hjosugi/electronics/docs/01-passive-rj45-design.md

# 1 MCU + パッシブ右手 + 8P8Cの設計

## 8P8CとRJ45という呼び方

一般に「RJ45」と呼ばれる8接点のモジュラーコネクタを使います。厳密には、コネクタ形状は8P8Cであり、RJ45は配線を含む登録ジャック規格名です。本資料では検索性のため「8P8C、通称RJ45」と表記します。

Ethernet用のマグネティクス内蔵ジャックではなく、8接点がそのまま基板へ出るモジュラージャックを選びます。採用部品の機械図、接点番号、シールド端子、内蔵LEDや内蔵抵抗の有無をデータシートで確認してください。

## Japanese duplex matrix

Japanese duplex matrixは、同じ行・列の組に、ダイオード方向が反対の2キーを割り当てる方式です。理論上、`行数 × 列数 × 2` 個のキーを `行数 + 列数` 本の信号で扱えます。

| 片側キー数 | 行 × 列 | 理論上の最大キー数 | 必要な信号線 |
| ---: | ---: | ---: | ---: |
| 18 | 3 × 3 | 18 | 6 |
| 21 | 4 × 3 | 24 | 7 |

42キーでは片側21キーなので、4 × 3の24枠のうち3枠を未使用にします。これはキーレイアウト上の割り当てであり、余った枠を物理キーへ接続する必要はありません。

ダイオード方向を使い分けるため、通常の一方向マトリクスとは走査方法が異なります。QMKで採用する場合は、Cheapinoなどの実装を参考にしつつ、対象キーボード専用のcustom matrix処理とテストが必要です。単に`MATRIX_ROWS`と`MATRIX_COLS`を設定するだけで完成するとは限りません。

## 提案ピン割り当て

次は、この教材で使用する論理ピン割り当てです。実部品の端子番号は、必ずジャックのデータシートと導通試験で照合します。

### 36キー、片側18キー

| 8P8C接点 | 信号 | 用途 |
| ---: | --- | --- |
| 1 | GND | ESD保護の基準、信号走査には本質的に不要 |
| 2 | NC | 将来予約。両側で未接続 |
| 3 | R_COL_0 | 右側Japanese duplex列0 |
| 4 | R_COL_1 | 右側Japanese duplex列1 |
| 5 | R_COL_2 | 右側Japanese duplex列2 |
| 6 | R_ROW_0 | 右側Japanese duplex行0 |
| 7 | R_ROW_1 | 右側Japanese duplex行1 |
| 8 | R_ROW_2 | 右側Japanese duplex行2 |

### 42キー、片側21キー

| 8P8C接点 | 信号 | 用途 |
| ---: | --- | --- |
| 1 | GND | ESD保護の基準 |
| 2 | R_ROW_3 | 右側Japanese duplex行3 |
| 3 | R_COL_0 | 右側Japanese duplex列0 |
| 4 | R_COL_1 | 右側Japanese duplex列1 |
| 5 | R_COL_2 | 右側Japanese duplex列2 |
| 6 | R_ROW_0 | 右側Japanese duplex行0 |
| 7 | R_ROW_1 | 右側Japanese duplex行1 |
| 8 | R_ROW_2 | 右側Japanese duplex行2 |

36キーと42キーで同じPCBを共用したい場合、接点2だけを未実装または`R_ROW_3`として扱えます。信号名、コネクタ番号、ケーブル側の接点番号をシルクと回路図の両方へ記載してください。

## GND線の意味

右側がスイッチとダイオードだけなら、キー電流は行線から列線へ戻るため、GNDはキーマトリクス走査そのものには必要ありません。それでも1本をGNDへ割り当てる理由は次の通りです。

- コネクタ付近のTVSアレイに短い帰路を与える
- ケーブルや筐体の静電気をMCUの信号ピン以外へ逃がす設計余地を残す
- 将来のシールド接続を検討しやすくする

GNDを設けただけでESD対策が完了するわけではありません。TVSの配置とGNDへの経路インダクタンスが重要です。右側へTVSを置く場合も電源は不要ですが、漏れ電流、接合容量、スタンドオフ電圧を確認します。

## 直列抵抗

MCUのGPIOと8P8Cコネクタの間に、各信号1本ずつ直列抵抗を入れます。

```text
RP2040 GPIO ── 470 Ω ── 8P8C ── ケーブル ── 右側スイッチ行列
```

初号機の採用値は470 Ωです。3.3 Vが理想的にGNDへ短絡した単純計算では、抵抗だけで制限される電流は次の値です。

| 直列抵抗 | `3.3 V / R` | 備考 |
| ---: | ---: | --- |
| 220 Ω | 15.0 mA | MCUによっては大きい。無条件には推奨しない |
| 330 Ω | 10.0 mA | 比較候補 |
| 470 Ω | 7.0 mA | 採用。信号立上りと入力閾値はngspiceと実機で確認する |

実際にはGPIO出力抵抗、ケーブル抵抗、接点抵抗も直列に入ります。一方、MCUの許容値は「設定できるドライブ強度」「通常動作条件」「絶対最大定格」「全GPIO合計」で意味が異なります。上表だけで安全判定せず、採用MCUと実装ボードのデータシートに照らします。

Japanese duplexで2本のGPIOが逆レベルを駆動して競合した場合、電流経路には原則として両側の直列抵抗が入ります。470 Ωを2本通る理想計算なら約3.5 mA以下になります。ただし、基板上の短絡が抵抗よりMCU側で起きた場合は保護されないため、抵抗はコネクタの近くではなく、信号源であるMCUと外部配線の間に確実に置きます。

## TVSアレイ

TVSはオプションですが、手で頻繁に触る外部コネクタでは配置用フットプリントを確保する価値があります。

- 3.3 V信号に適したスタンドオフ電圧
- キーマトリクスの立上りを壊さない接合容量
- MCUの入力クランプより先にサージ電流を逃がせるクランプ特性
- コネクタ直後に置き、TVSからGNDへの配線を短く太くする

たとえば[TI TPD2EUSB30A](https://www.ti.com/product/TPD2EUSB30A)は2チャネル、3.6 Vの`VRWM`、代表0.7 pFの製品ですが、これは選定例でありBOM確定ではありません。必要チャネル数、パッケージ、実装能力、クランプ電圧を含めて比較してください。

## ケーブルと誤接続対策

- 市販の8P8Cストレート結線パッチケーブルを使う
- クロスケーブル、電話線、片側だけ配列が違う自作ケーブルを混ぜない
- 初回接続前に1-1、2-2、…、8-8の導通をテスターで確認する
- 基板とケースに`SPLIT ONLY / NO LAN / NO PoE`と明記する
- Ethernetスイッチ、ルーター、PoEインジェクターへ接続しない
- LANケーブルと見分けられる短い色やラベルを専用品として固定する

8P8Cを採用する最大の注意点は、Ethernetに見えることです。パッシブ右側へ電源を送らない設計でも、PoE機器や故障した配線への誤接続を安全にする保証はありません。利用者が迷わない外観と表示は回路の一部として扱います。

## 回路図レビューで確認すること

- `VBUS`、`5V`、`3V3`、`RAW`のネットが中央コネクタに接続されていない
- すべての外部マトリクス線が直列抵抗を通る
- コネクタのシールド端子と信号GNDの扱いが意図どおり
- TVSの向き、GND帰路、スタンドオフ電圧が正しい
- 左右コネクタのミラー配置でピン番号が逆転していない
- NC接点に銅箔やテストパッドから意図しない接続がない
- ERCで電源警告を無理に非表示にしていない
