hjosugi/electronics/issues/11-hotplug-test.md

# [test] ホットプラグ安全性テスト計画
Labels: safety,test

## テスト項目 (プロトタイプ完成後)
- 電流制限付き電源で活線挿抜100回 → 全キー動作確認
- 通常の半挿し状態で供給電流、3V3、代表GPIOを観測する。コネクタを傷める斜め挿しや無保護の意図的短絡は行わない
- 誤配線は実LAN機器へ接続せず、無通電の導通試験と電流制限付きfault-injection治具で評価する
- 挿抜中のキー誤入力、押下残り、USB再列挙の有無を記録

## 完了条件
- 試験治具、電流上限、ケーブル、基板SHA、firmware SHAと結果を`docs/`に記録
- 問題があれば個別 issue 化
