hjosugi/electronics/issues/09-sim-protection.md

# [sim] 保護回路の ngspice シミュレーション
Labels: simulation

## 背景
キーマトリクスのデジタル動作はシミュレーションの対象にしない (ERC/DRC と実機で見る)。シミュレーションする価値があるのは中央ケーブルまわりのアナログ部分。

## モデル
- GPIO出力: 電圧源3.3 V + 仮の出力抵抗。最終値はRP2040/採用モジュールのデータシートまたは実測で確認
- 直列抵抗: 220 / 330 / 470Ω を振る
- ケーブル寄生: 実ケーブルの仕様またはLCR測定からR/L/Cを決め、集中定数モデルの妥当性を記録
- TVS: メーカ配布 SPICE モデル (PSpice 形式) を ngspice 向けに変換。難しければ「接合容量 + クランプダイオード」で近似
- 受け側: 採用MCUの入力容量と内蔵プルアップ条件をデータシートから設定

## 見るもの
1. 過渡解析: スキャンパルスの立ち上がり波形。直列 R によるなまりがスキャン周期に対して十分速いか
2. 直列 R とプルアップの分圧で L レベルが閾値を割れているか
3. TVS 容量追加で波形が崩れないか

## 手順
- CircuitJS1で概念確認 → ngspiceネットリスト → KiCad 10内蔵シミュレータで本検証
- 回路とシミュレーション設定を `hardware/sim/` にコミット

## 完了条件
- 採用する直列 R 値がシミュレーション根拠付きで決まり、docs/adr/ に記録される
