hjosugi/electronics/hardware/split-keyboard/split-keyboard.kicad_sch

## KiCad design hardware/split-keyboard/split-keyboard.kicad_sch (2026-08-01)

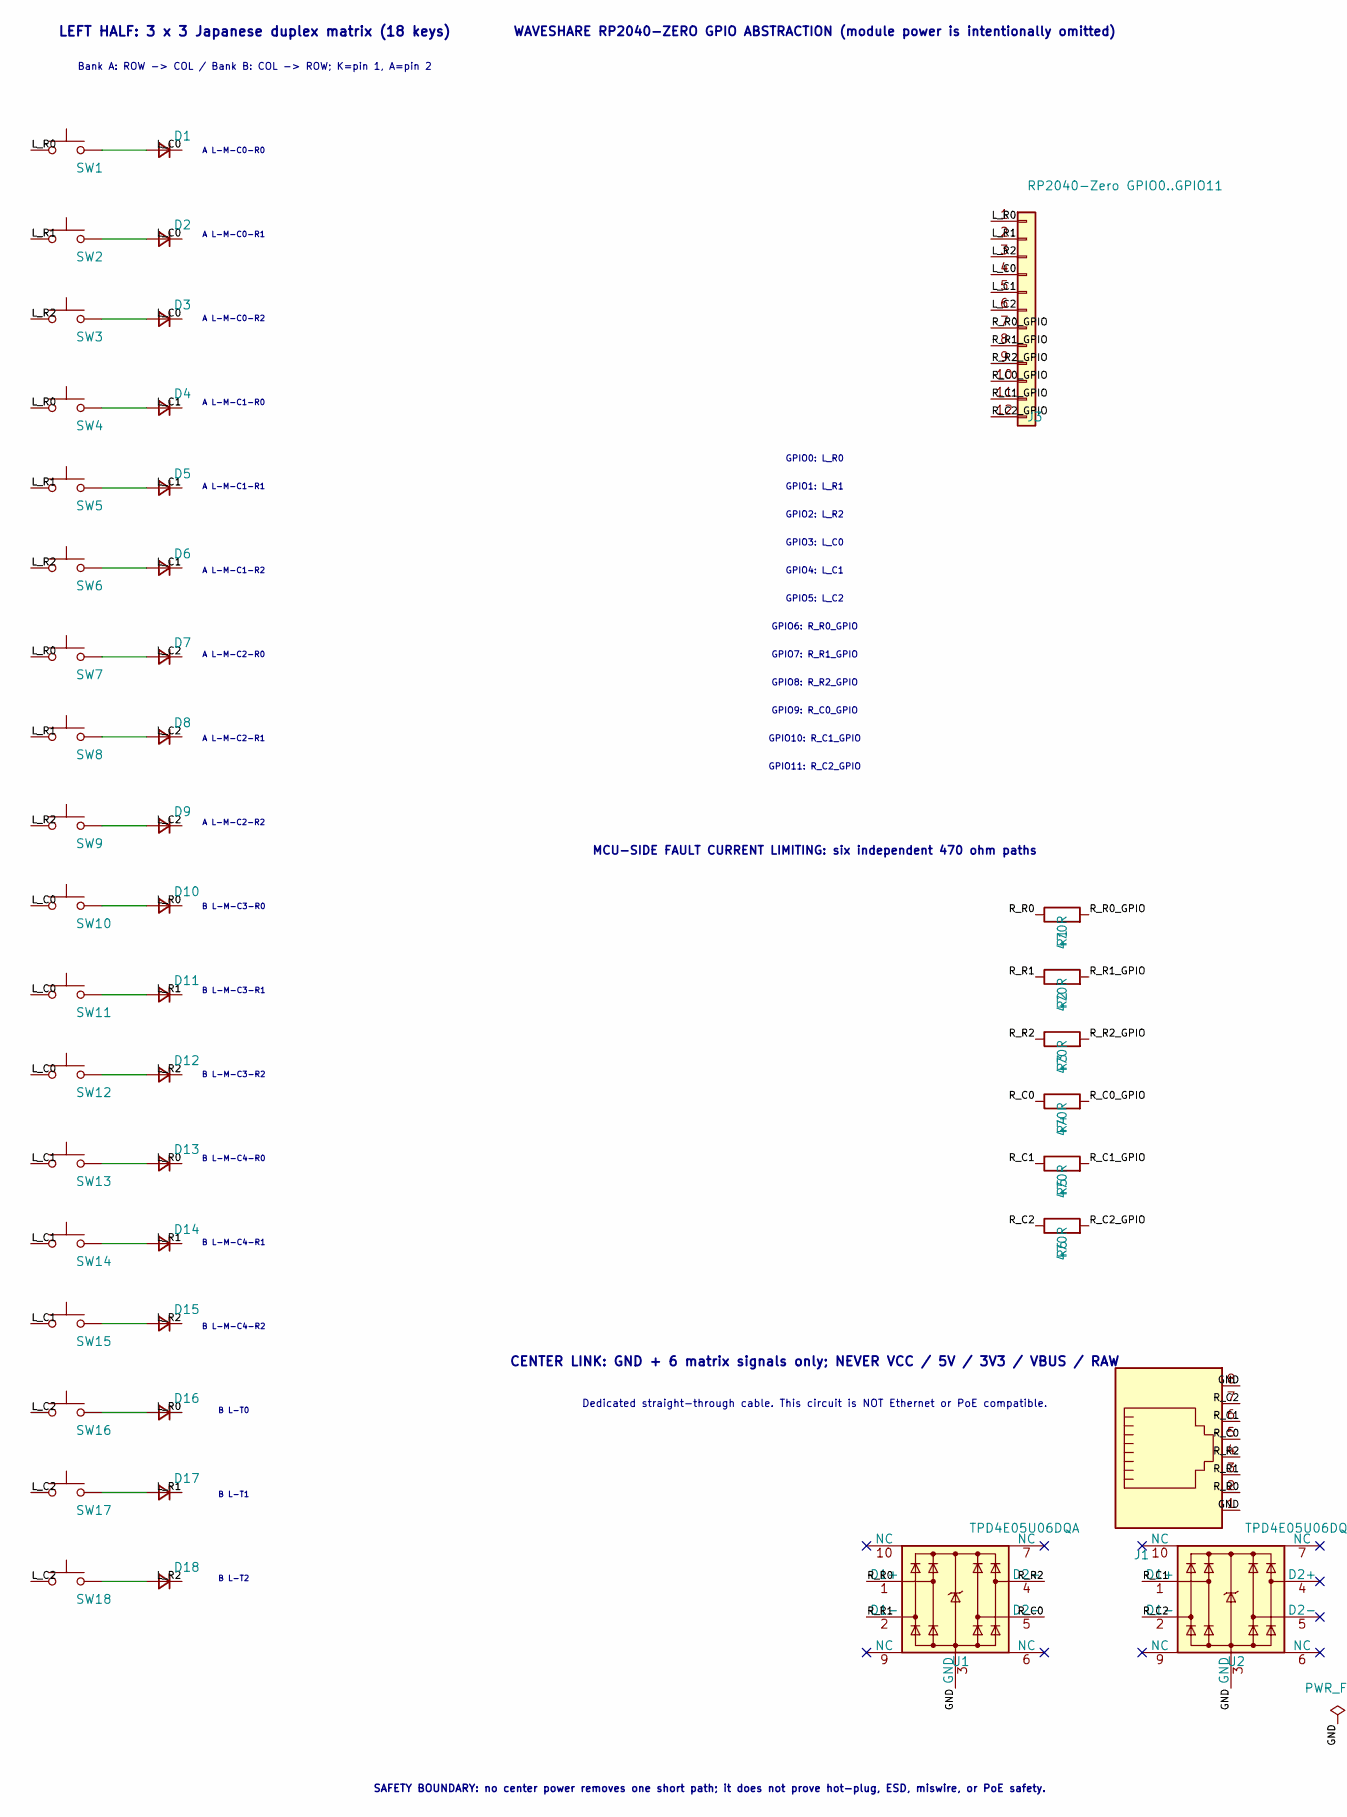
[picture p1: schematic split-keyboard.kicad_sch, part in row 1, column 1]

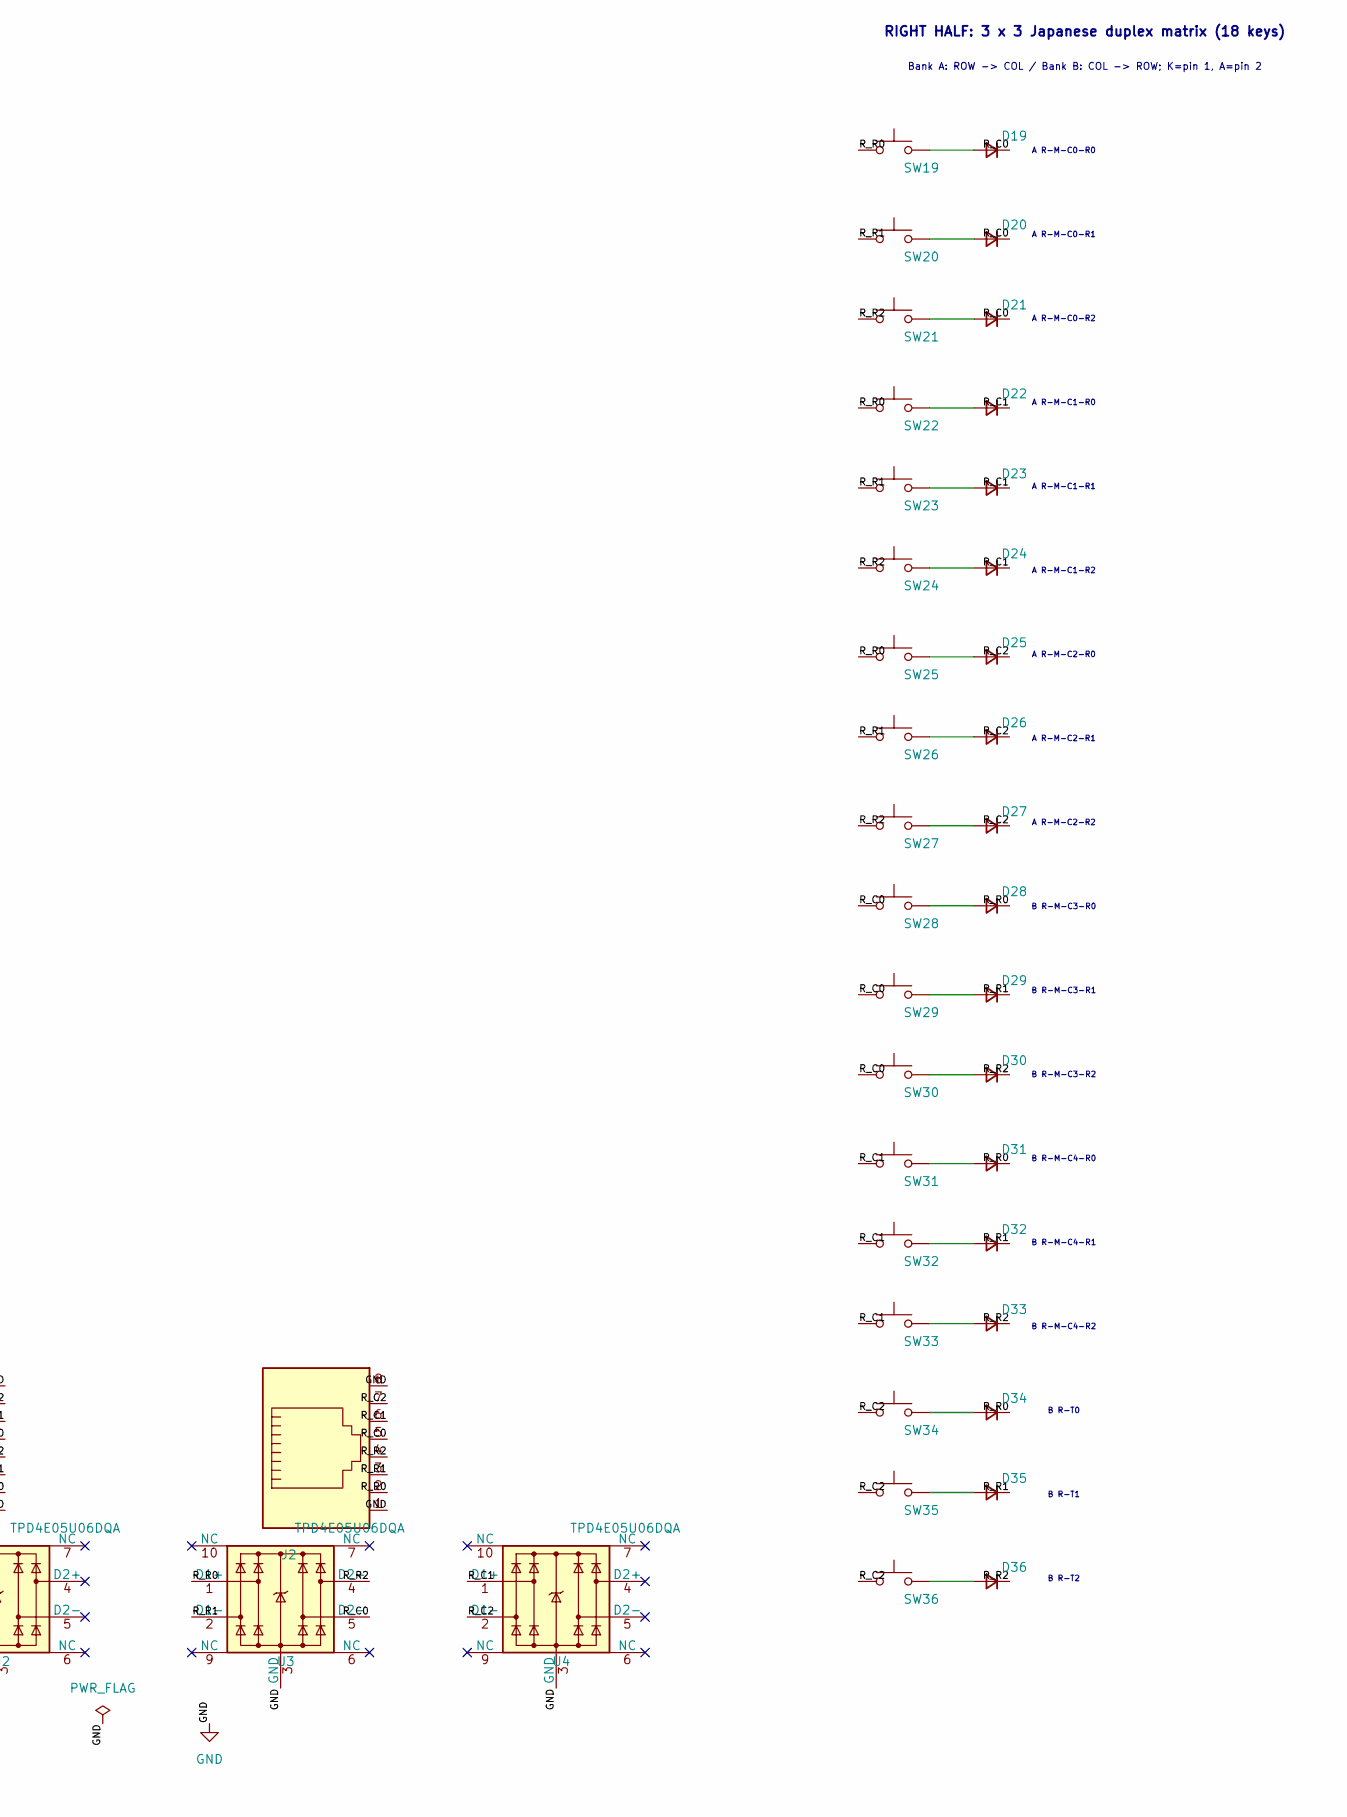
[picture p2: schematic split-keyboard.kicad_sch, part in row 1, column 2]

Parts:
D1, D2, D3, D4, D5, D6, D7, D8, D9, D10, D11, D12, D13, D14, D15, D16, D17, D18, D19, D20, D21, D22, D23, D24, D25, D26, D27, D28, D29, D30, D31, D32, D33, D34, D35, D36: 1N4148W; D_SOD-123; MPN 1N4148W-7-F
J1: 8P8C LEFT - SPLIT ONLY / NO LAN
J2: 8P8C RIGHT - SPLIT ONLY / NO LAN
J3: RP2040-Zero GPIO0..GPIO11
R1, R2, R3, R4, R5, R6: 470R; R_0603_1608Metric; MPN ERJ3EKF4700V
SW1, SW2, SW3, SW4, SW5, SW6, SW7, SW8, SW9, SW10, SW11, SW12, SW13, SW14, SW15, SW16, SW17, SW18, SW19, SW20, SW21, SW22, SW23, SW24, SW25, SW26, SW27, SW28, SW29, SW30, SW31, SW32, SW33, SW34, SW35, SW36: KEY
U1, U2, U3, U4: TPD4E05U06DQA; USON-10_2.5x1.0mm_P0.5mm; MPN TPD4E05U06DQA

Connections:
GND: J1.1, J1.8, J2.1, J2.8, U1.3 (GND), U1.8 (GND), U2.3 (GND), U2.8 (GND), U3.3 (GND), U3.8 (GND), U4.3 (GND), U4.8 (GND)
L_C0: D1.1 (K), D2.1 (K), D3.1 (K), J3.4, SW10.1, SW11.1, SW12.1
L_C1: D4.1 (K), D5.1 (K), D6.1 (K), J3.5, SW13.1, SW14.1, SW15.1
L_C2: D7.1 (K), D8.1 (K), D9.1 (K), J3.6, SW16.1, SW17.1, SW18.1
L_R0: D10.1 (K), D13.1 (K), D16.1 (K), J3.1, SW1.1, SW4.1, SW7.1
L_R1: D11.1 (K), D14.1 (K), D17.1 (K), J3.2, SW2.1, SW5.1, SW8.1
L_R2: D12.1 (K), D15.1 (K), D18.1 (K), J3.3, SW3.1, SW6.1, SW9.1
unnamed: D1.2 (A), SW1.2
unnamed: D2.2 (A), SW2.2
unnamed: D3.2 (A), SW3.2
unnamed: D4.2 (A), SW4.2
unnamed: D5.2 (A), SW5.2
unnamed: D6.2 (A), SW6.2
unnamed: D7.2 (A), SW7.2
unnamed: D8.2 (A), SW8.2
unnamed: D9.2 (A), SW9.2
unnamed: D10.2 (A), SW10.2
unnamed: D11.2 (A), SW11.2
unnamed: D12.2 (A), SW12.2
unnamed: D13.2 (A), SW13.2
unnamed: D14.2 (A), SW14.2
unnamed: D15.2 (A), SW15.2
unnamed: D16.2 (A), SW16.2
unnamed: D17.2 (A), SW17.2
unnamed: D18.2 (A), SW18.2
unnamed: D19.2 (A), SW19.2
unnamed: D20.2 (A), SW20.2
unnamed: D21.2 (A), SW21.2
unnamed: D22.2 (A), SW22.2
unnamed: D23.2 (A), SW23.2
unnamed: D24.2 (A), SW24.2
unnamed: D25.2 (A), SW25.2
unnamed: D26.2 (A), SW26.2
unnamed: D27.2 (A), SW27.2
unnamed: D28.2 (A), SW28.2
unnamed: D29.2 (A), SW29.2
unnamed: D30.2 (A), SW30.2
unnamed: D31.2 (A), SW31.2
unnamed: D32.2 (A), SW32.2
unnamed: D33.2 (A), SW33.2
unnamed: D34.2 (A), SW34.2
unnamed: D35.2 (A), SW35.2
unnamed: D36.2 (A), SW36.2
R_C0: D19.1 (K), D20.1 (K), D21.1 (K), J1.5, J2.5, R4.1, SW28.1, SW29.1, SW30.1, U1.5 (D2-), U3.5 (D2-)
R_C0_GPIO: J3.10, R4.2
R_C1: D22.1 (K), D23.1 (K), D24.1 (K), J1.6, J2.6, R5.1, SW31.1, SW32.1, SW33.1, U2.1 (D1+), U4.1 (D1+)
R_C1_GPIO: J3.11, R5.2
R_C2: D25.1 (K), D26.1 (K), D27.1 (K), J1.7, J2.7, R6.1, SW34.1, SW35.1, SW36.1, U2.2 (D1-), U4.2 (D1-)
R_C2_GPIO: J3.12, R6.2
R_R0: D28.1 (K), D31.1 (K), D34.1 (K), J1.2, J2.2, R1.1, SW19.1, SW22.1, SW25.1, U1.1 (D1+), U3.1 (D1+)
R_R0_GPIO: J3.7, R1.2
R_R1: D29.1 (K), D32.1 (K), D35.1 (K), J1.3, J2.3, R2.1, SW20.1, SW23.1, SW26.1, U1.2 (D1-), U3.2 (D1-)
R_R1_GPIO: J3.8, R2.2
R_R2: D30.1 (K), D33.1 (K), D36.1 (K), J1.4, J2.4, R3.1, SW21.1, SW24.1, SW27.1, U1.4 (D2+), U3.4 (D2+)
R_R2_GPIO: J3.9, R3.2

Notes on the sheet:
GPIO7: R_R1_GPIO
B L-M-C4-R2
A R-M-C1-R2
B R-T1
Dedicated straight-through cable. This circuit is NOT Ethernet or PoE compatible.
A L-M-C1-R2
B R-T2
SAFETY BOUNDARY: no center power removes one short path; it does not prove hot-plug, ESD, miswire, or PoE safety.
B R-M-C3-R1
A R-M-C1-R1
A R-M-C0-R0
B R-M-C4-R0
A L-M-C0-R1
B L-T2
GPIO10: R_C1_GPIO
RIGHT HALF: 3 x 3 Japanese duplex matrix (18 keys)
A L-M-C2-R2
GPIO8: R_R2_GPIO
A R-M-C0-R2
B R-T0
B R-M-C4-R2
B R-M-C3-R2
GPIO11: R_C2_GPIO
A L-M-C2-R1
A L-M-C1-R0
A L-M-C2-R0
LEFT HALF: 3 x 3 Japanese duplex matrix (18 keys)
B L-M-C3-R2
GPIO6: R_R0_GPIO
B R-M-C3-R0
A L-M-C0-R0
B L-T1
GPIO0: L_R0
A L-M-C1-R1
GPIO4: L_C1
MCU-SIDE FAULT CURRENT LIMITING: six independent 470 ohm paths
B L-M-C4-R0
GPIO5: L_C2
A R-M-C2-R0
B L-M-C3-R1
GPIO9: R_C0_GPIO
CENTER LINK: GND + 6 matrix signals only; NEVER VCC / 5V / 3V3 / VBUS / RAW
A R-M-C0-R1
GPIO1: L_R1
A R-M-C1-R0
A L-M-C0-R2
B R-M-C4-R1
GPIO2: L_R2
B L-M-C4-R1
A R-M-C2-R1
B L-T0
A R-M-C2-R2
Bank A: ROW -> COL / Bank B: COL -> ROW; K=pin 1, A=pin 2
B L-M-C3-R0
GPIO3: L_C0
WAVESHARE RP2040-ZERO GPIO ABSTRACTION (module power is intentionally omitted)
