hjosugi/electronics/(commit log)

2026-08-01 分割キーボード安全設計資料を公開
2026-08-01 v0.1.0のリリース日を確定
2026-08-01 Issue登録の再試行を追加
2026-08-01 Issue #1: KiCad 10環境スモークテストを追加
    空回路ERC、RC過渡解析、KiCad 10コンテナCIを追加し、CachyOS/Arch向け手順と検証結果を文書化する。
    [empty.kicad_sch]
2026-08-01 Issue #8: 初号機のRP2040-Zero採用を決定
    Waveshare RP2040-Zeroを初号機に採用し、電源上の注意、代替案、実装条件、再検討条件をADRへ記録する。
2026-08-01 Issue #4: ERC/DRC violationのnegative CIを追加
    KiCad 10のERC/DRC violation fixtureを追加し、終了コード5と違反IDをCIで検証する。
    [drc-open-outline.kicad_pcb, erc-dangling-wire.kicad_sch]
2026-08-01 検証処理を並列化して高速化
    独立した検査とSPICE回路を並列実行し、KiCadはロック競合を避けて順序実行する。CIの古い同一ref実行をキャンセルし、環境診断・性能測定・NotebookLM資料を追加する。
2026-08-01 Issue #5: 調整可能な36キーChoc v1レイアウトを追加 (#17)
    36キーChoc v1の制限付きプロファイル、KLE/mm JSON、ADR、ドキュメントページとCSS変数検証を追加する。Kinesis系のtrue keywellはIssue #16で実機比較する。
    [build-layout.py, check-document-css.py, rewrite-markdown-links.py]
2026-08-01 docs: GitHub Pagesで設計資料を公開 (#18)
    docs/をGitHub Pages artifactとして検証・公開し、READMEとHTMLの公開URLを整える。
2026-08-01 docs: ドキュメントCSSのタイポグラフィを一貫した変数へ統一 (#19)
    見出し、ラベル、本文のタイポグラフィトークンを統一し、直書きと未定義変数をCIで検出する。
2026-08-01 Issue #6 #7 #9: 470Ωパッシブ分割安全回路 (#20)
    36キーJapanese duplex matrix、中央無給電8P8C、470Ω直列抵抗、両端TVS、構造検査、SPICE感度解析と安全境界を追加する。
    [split-keyboard.kicad_sch]
2026-08-01 Issue #2: RP2040 QMK UF2再現ビルド (#21)
    36キーJapanese duplex custom matrix、固定QMK commit、ローカル/CI UF2ビルド、artifact、QMK lint、静的検査、GPL通知とドキュメントを追加する。
    [check-qmk-source.py, matrix.c]
2026-08-01 Issue #10: duplex matrix自動テストとghost抑制 (#22)
    QMK native test 6件、左右duplex scan共通実装、保守的ghost filter、実機2x2試験手順を追加。
    Issue #10 の実機ブレッドボード検証は未完のため、Issueは継続する。
    [check-qmk-source.py, duplex_matrix.c, duplex_matrix.h, matrix.c]
2026-08-02 Issue #10 #12: breadboard試験と発注ready判定 (#23)
    2 × 2 breadboardの具体的な配線・入力・ghost・抜線試験と、NotebookLM/PCB発注の明示的なNOT READY gateを追加。
    Issue #10/#12の実機・外部サービス項目は未完のため継続する。
    [check-order-readiness.py]
2026-08-02 Issue #24: 根拠付きproject graphをPagesへ追加 (#25)
    curatedな19 node/17 edge、確度と根拠付きの静的Pages UI、schema/CSS/JS検査、9並列validationを追加する。
    live Pages read-back完了までIssue #24は継続する。
    [check-document-css.py, check-project-graph.py]
2026-08-02 Issue #24: graph filter modelを自動テストする (#26)
    Pages graphの検索・絞り込みを純粋関数へ分離し、Node標準テスト5件と公開根拠の状態更新を追加する。
    [check-project-graph.py]
